berrak/Arduino-Talkie-Speech-Amplifier/board-dimensions/mechanical-dimensions.png

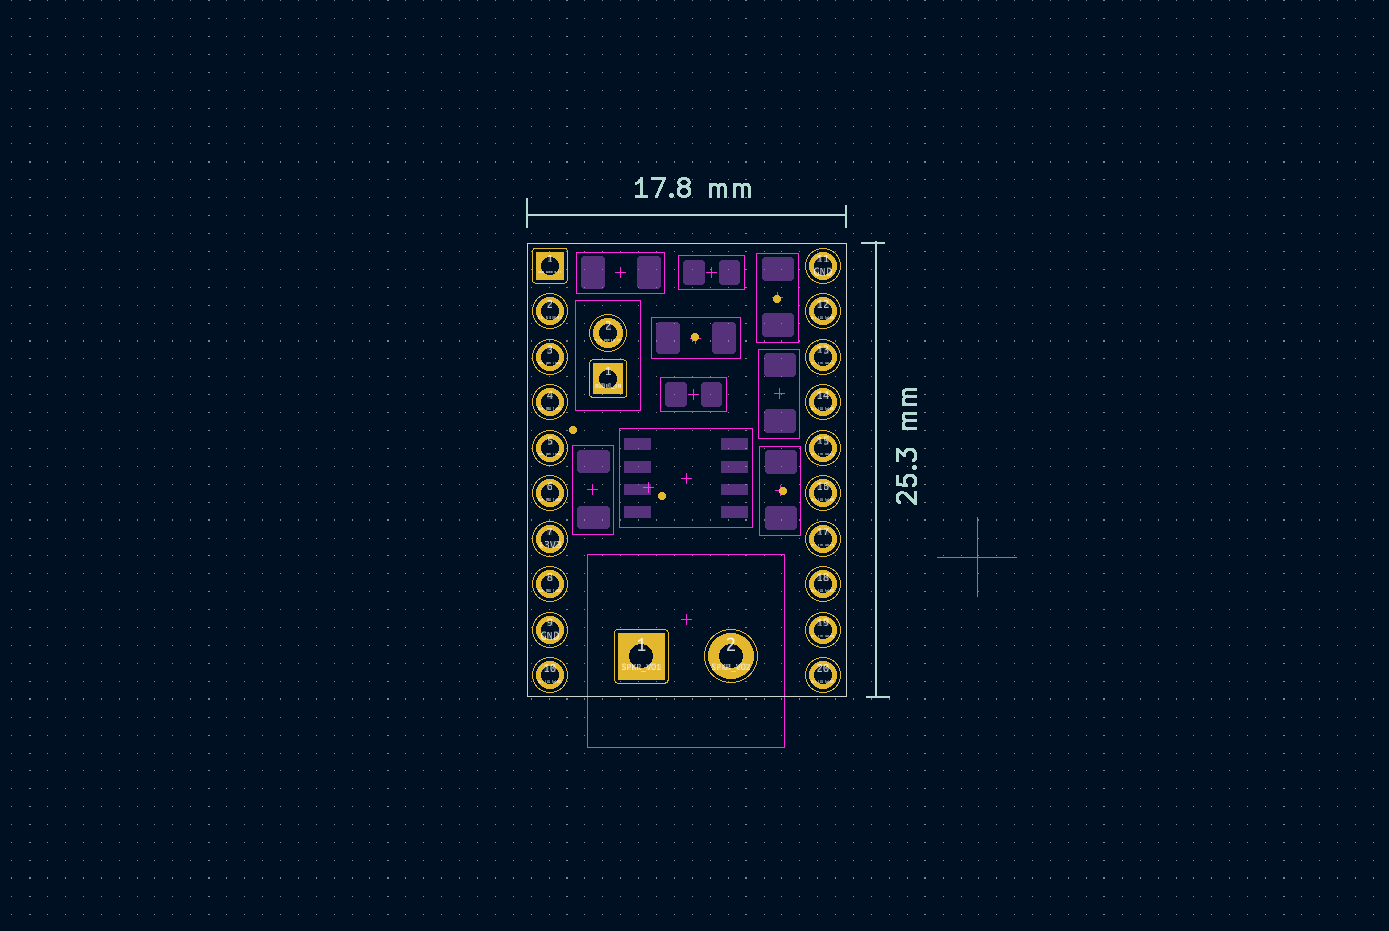
board-dimensions/mechanical-dimensions.png
