berrak/Arduino-Talkie-Speech-Amplifier/images/3d-view-speech-audio-amplifier-v1_0.png

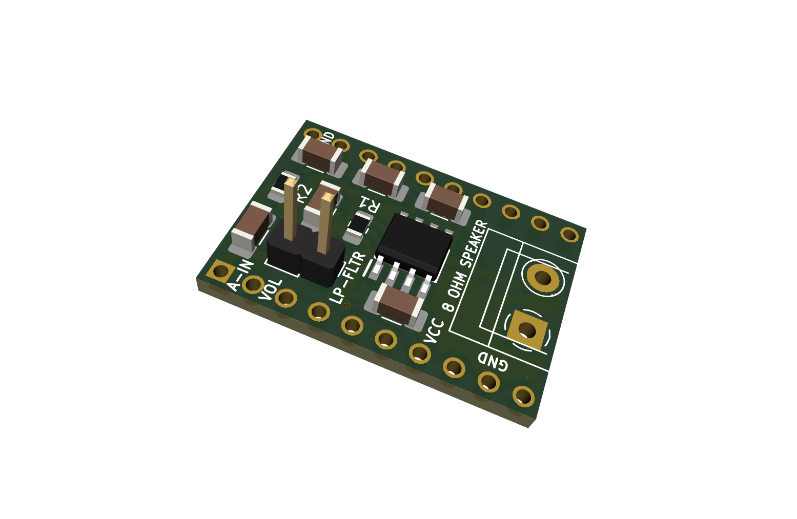
images/3d-view-speech-audio-amplifier-v1_0.png
