berrak/Arduino-Talkie-Speech-Amplifier/images/audio-shield-topview.jpg

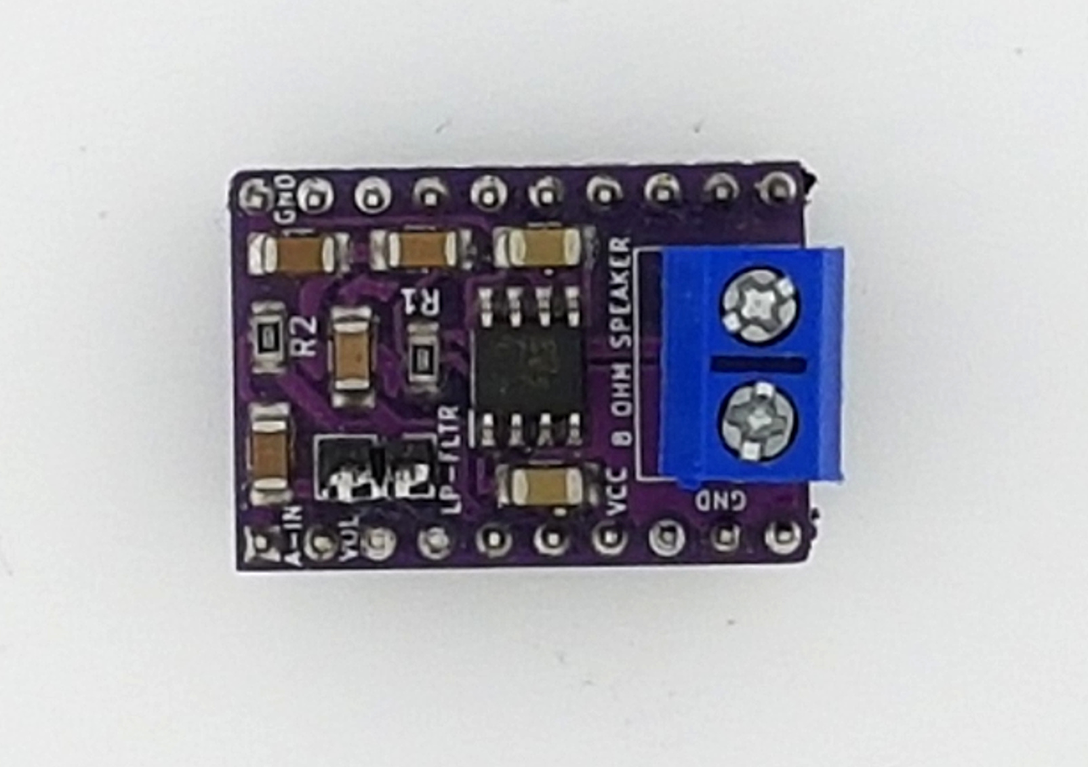
images/audio-shield-topview.jpg
