berrak/Arduino-Talkie-Speech-Amplifier/schematic-diagram/pinout-tinypico.jpg

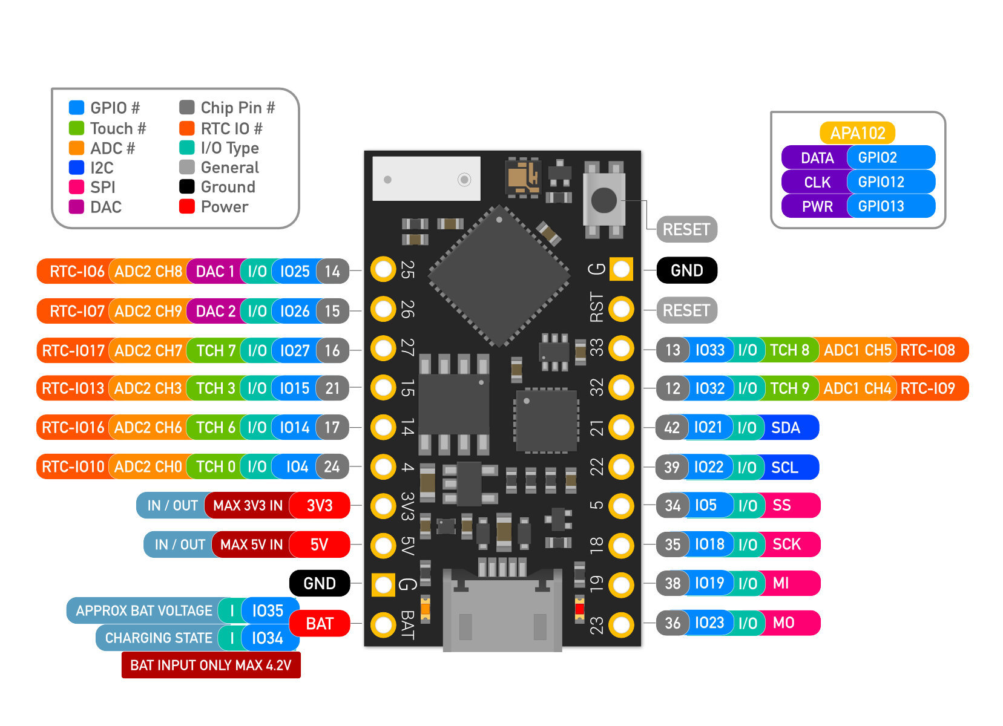
schematic-diagram/pinout-tinypico.jpg
