berrak/Arduino-Talkie-Speech-Amplifier/schematic-diagram/schematic-speech-audio-amplifier-shield-UM-ESP32-v1_0.pdf

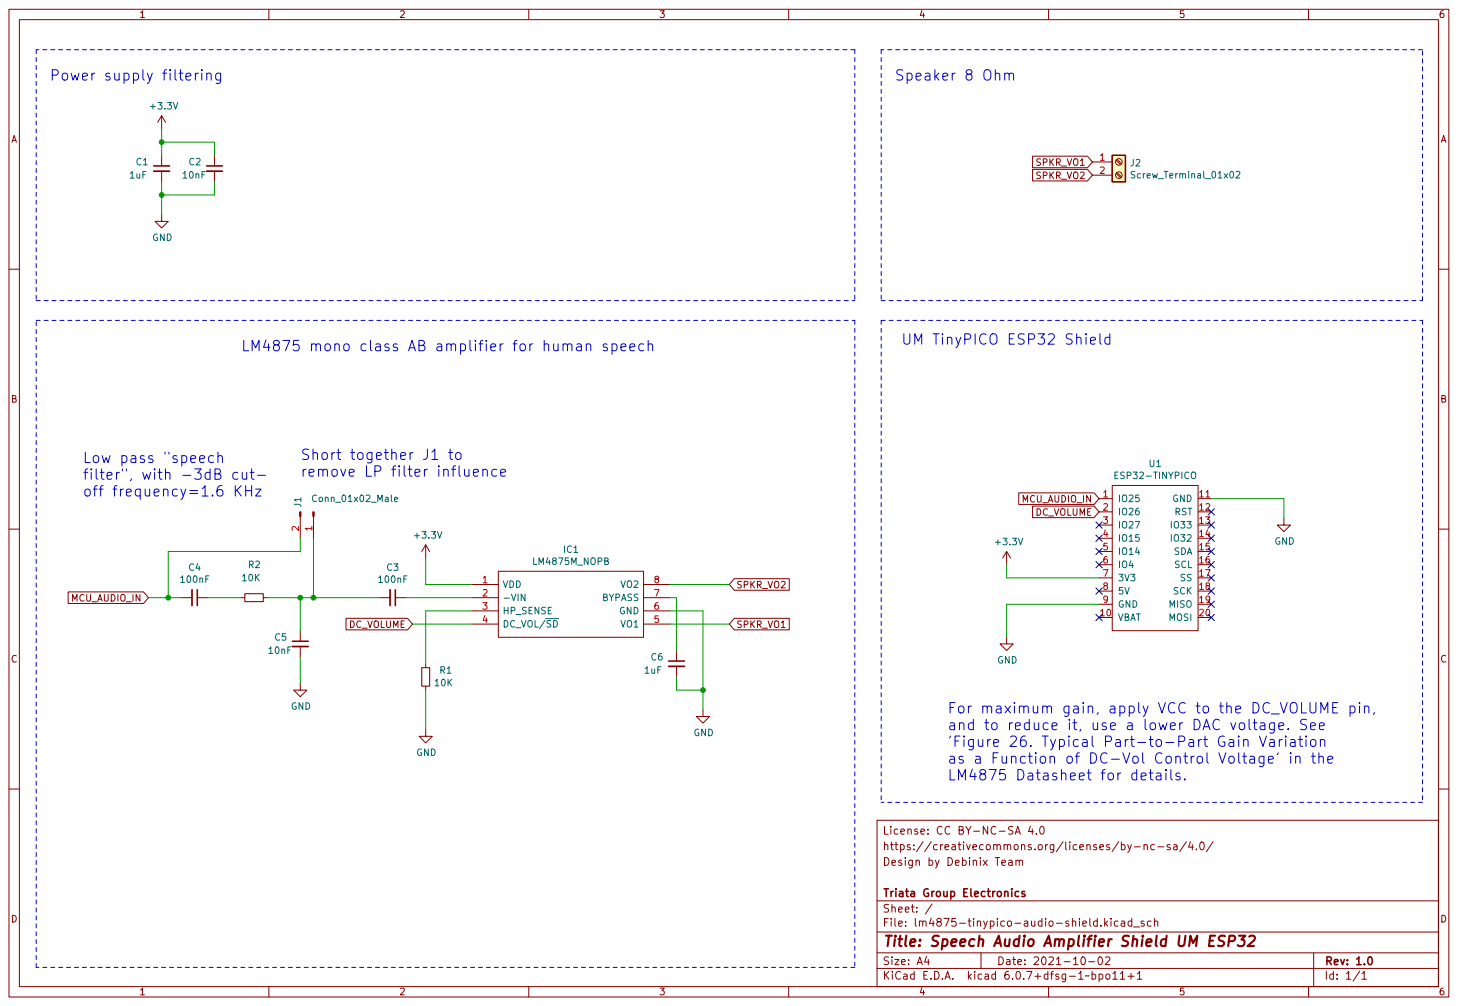
[picture p8: page 1]

SPKR_VO1 LM4875 mono class AB amplifier for human speech

Short together J1 to
remove LP filter influence

For maximum gain, apply VCC to the DC_VOLUME pin,
and to reduce it, use a lower DAC voltage. See
'Figure 26. Typical Part-to-Part Gain Variation
as a Function of DC-Vol Control Voltage' in the
LM4875 Datasheet for details.

https://creativecommons.org/licenses/by-nc-sa/4.0/ License: CC BY-NC-SA 4.0

Design by Debinix Team

File: lm4875-tinypico-audio-shield.kicad_sch Sheet: / Triata Group Electronics

Id: 1/1 Title: Speech Audio Amplifier Shield UM ESP32
