berrak/Arduino-Talkie-Speech-Amplifier/examples/updaterobotOTA/updaterobotOTA.ino

// MIT License

// Copyright (c) 2021 Ralph Bacon 

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
//==================================================================================
// Name         : updaterobotOTA.ino
// Author       : Modified original by Debinix Team (c).
// Source       : Link to Ralph's YouTube video: https://youtu.be/OaHzlBTUrRQ
// License      : The MIT Licence.
// Version      : Date 2022-10-15.
// Required libs: Install AsyncTCP, ESPAsyncWebServer, and AsyncElegantOTA.
//
// Description : This example shows how to use OTA to update the vocabulary
//               on a previously fielded ESP32 TinyPICO Talkie robot.
// NOTE        : Make changes in this file only.   
// ----
// What's next : Browse predefined vocabulary with the shell script 'talkie-vocab.sh'. 
//==================================================================================

#include <TinyPICO.h>

#include <Talkie.h>
#include "Vocab_US_Clock.h"
#include "Vocab_US_Large.h"

#include "Identification.h"     // OTA stuff - no changes are required

Talkie voice;

// Initialise the TinyPICO Dotstar library
TinyPICO tp = TinyPICO();

// Set your WiFi credentials!
const char *SSID = "FW114";
const char *PASSWORD = "";

// OTA stuff included here
String projectTitle = "Arduino Talkie Speech Amplifier";
String projectDesc = "ESP32 TinyPICO demo for updates of a Talkie robot device! <p>You can write text here or <b>html</b>.</p> ";

const int volDAC = 26;   // GPIO26 controls speaker volume

void setup()
{
    // 8bit DAC '255' = max voltage/volume out, i.e. 3.3V. 
    dacWrite(volDAC, 255); 

    // Everything for OTA updates
    otaInit();
}


void loop()
{
    // Variables just for this function
    static unsigned long counter = 1;
    static unsigned long prevMillis = 0;

    // We'll update a counter every few seconds
    if (millis() - prevMillis > 3000)
    {
        printf("Counter is now %ld\n", ++counter);
        prevMillis = millis();
    }

    // Comment/uncomment each section in turn
    //---------------------------------------
    // One version of code
    tp.DotStar_SetPixelColor( 0, 255, 0 );  // Fix green 
    voice.say(spc_GOOD);
    voice.say(spc_MORNING);
    delay(2500);

    // New version of code 
//  tp.DotStar_SetPixelColor( 255, 0, 0 );  // Fix red
//  voice.say(sp2_DANGER);
//  voice.say(sp2_DANGER);
//  voice.say(sp2_RED);
//  voice.say(sp2_ALERT);
//  delay(2500);

}
