berrak/Arduino-Talkie-Speech-Amplifier/(commit log)

2022-10-18 reversed OTA example code back to original after test
    [updaterobotOTA.ino]
2022-10-25 clarify esp32s2 and esp32s3 status
2022-10-26 add link to adafruit ESP32-S2
2022-10-26 correct pin
